matteob29/EA113_-_Generateur_de_son/Simulations/3)_Multiplieur/III.3.f).JPG

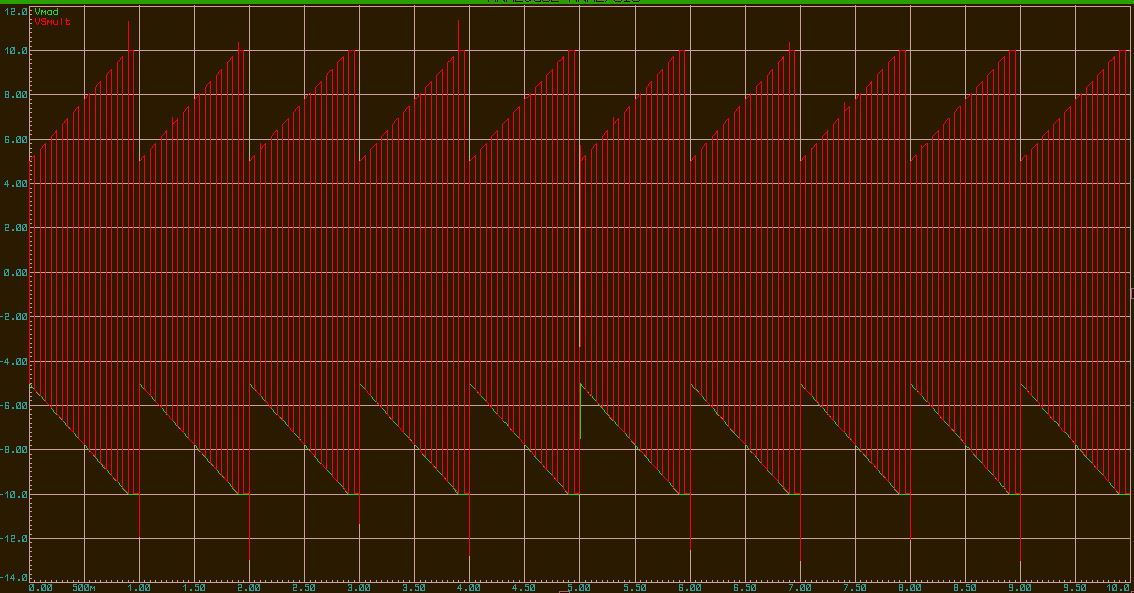
Simulations/3)_Multiplieur/III.3.f).JPG
