matteob29/EA113_-_Generateur_de_son/Simulations/5)_VCO_5/III.Vhf(t).JPG

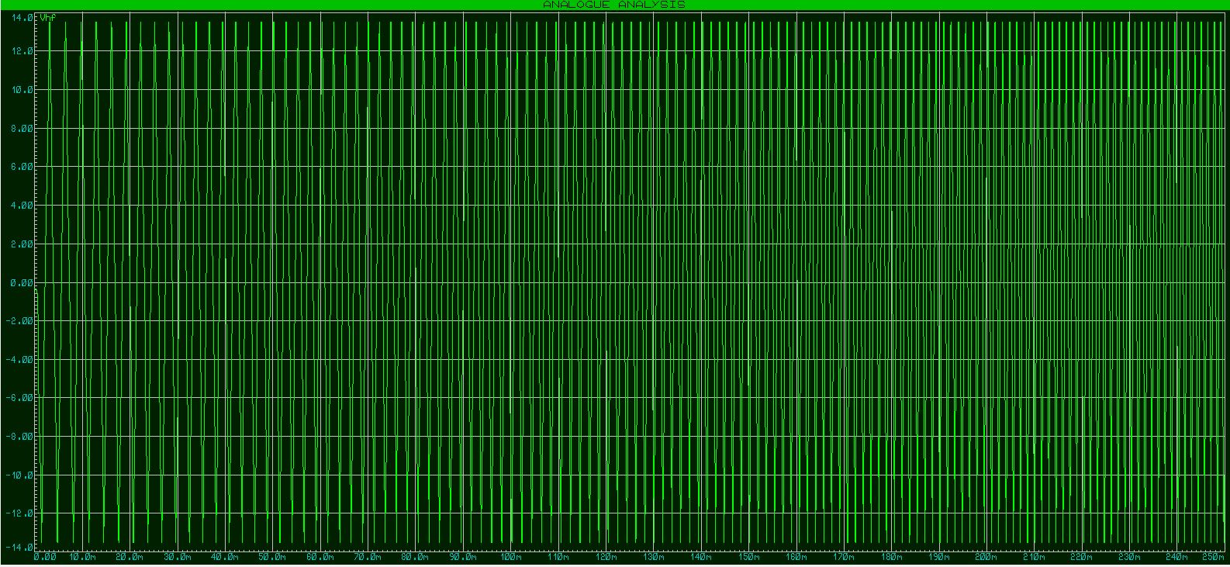
Simulations/5)_VCO_5/III.Vhf(t).JPG
