matteob29/EA113_-_Generateur_de_son/Rapport/[EA113] - générateur de son.pdf

# Générateur de son

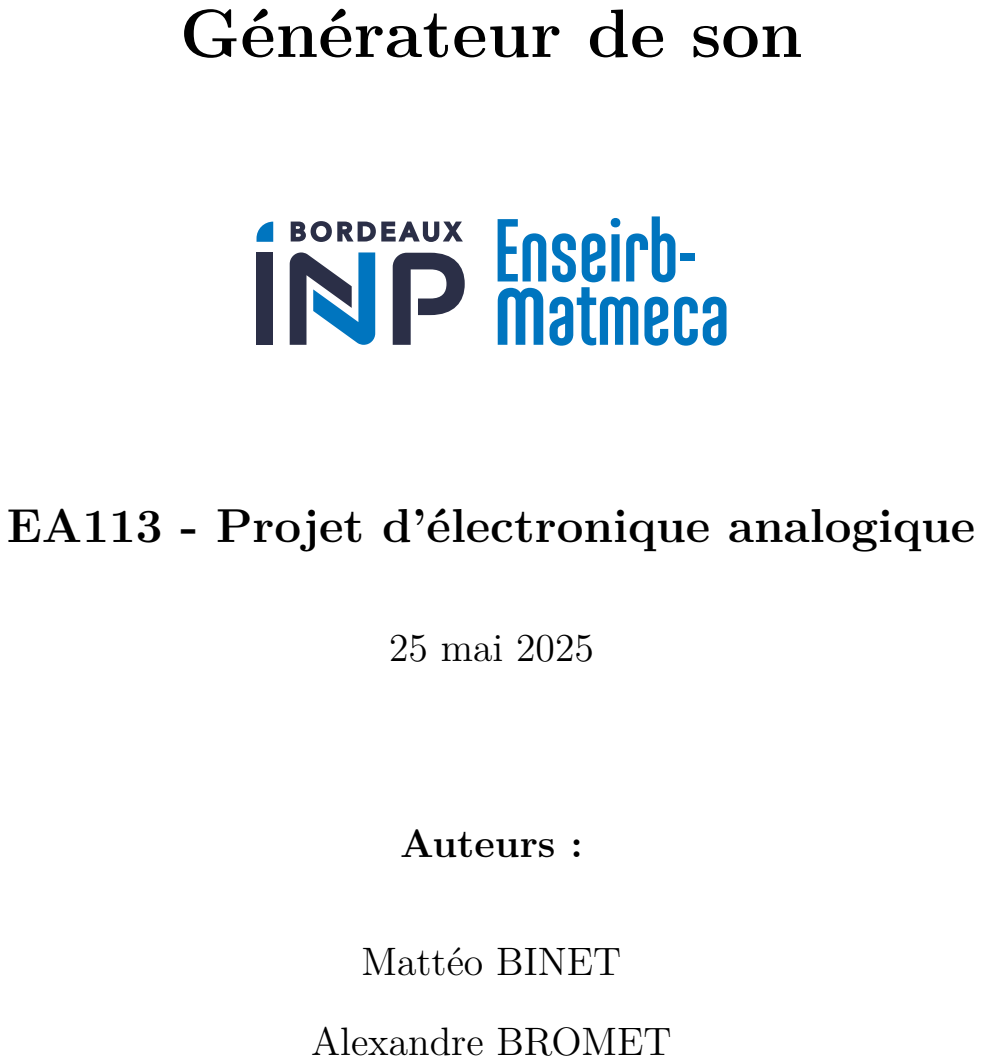
[picture p3: page 1]
25 mai 2025; Auteurs :; Mattéo BINET; Alexandre BROMET

EA113 - Projet d’électronique analogique

## Sommaire

Introduction | 1
1 Cahier des Charges | 1
2 Générateur de modulation NE555 | 2
3 Adaptation du signal généré par le NE555 | 2
4 Voltage Controlled Oscillator (VCO) | 3
5 Adaptation du signal sortant du VCO | 8
Conclusion | 9
Annexe | 10

EA113 - Projet d’électronique analogique

## Introduction

Ce rapport présente l’étude théorique du générateur de son conçu dans le cadre du projet EA113. L’objectif est de produire un signal audio modulé en fréquence à l’aide d’un oscillateur commandé en tension, selon un cahier des charges précis. L’analyse porte sur la conception des différents blocs fonctionnels, le choix et le dimensionnement des composants, ainsi que la validation par simulation et mesures.

## 1 Cahier des Charges

Le système à concevoir doit permettre la génération d’un signal sonore destiné à être diffusé sur un haut-parleur via un amplificateur audio. Le signal de sortie sera de forme triangulaire, avec une fréquence variant périodiquement entre deux valeurs extrêmes notées FMIN et FMAX, selon une modulation en fréquence (FM) de type wobulation.
Les principales exigences du cahier des charges sont les suivantes :

— Forme du signal : triangulaire, périodique et symétrique.
— Fréquences extrêmes : FMIN = 100 Hz, FMAX = 1500 Hz (valeurs à adapter selon l’effet sonore choisi).

— Type de modulation : variation pseudo-linéaire ou binaire, avec un signal modulant Vmod de fréquence faible (de l’ordre du hertz).

— Rapport cyclique de la modulation : adapté selon l’effet recherché (montée lente et descente rapide pour une sirène, par exemple).

— Amplitude du signal de sortie : ajustable, de 0 à environ 100 mV, compatible avec l’entrée de l’amplificateur.
— Alimentation : double alimentation symétrique ±15 V.

Le circuit doit être robuste, stable et répondre aux contraintes de dimensionnement en tenant compte des tolérances des composants. Sa conception doit également permettre une intégration simple sur une carte imprimée (PCB).

Mattéo BINET | 1 | Alexandre BROMET

## 2 Générateur de modulation NE555

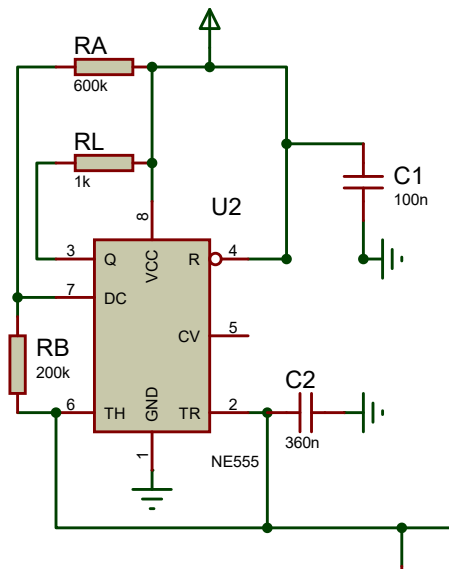
[picture p4: figure]
3 GND 1 VCC

Figure 1 – Schématique Proteus du générateur de modulation NE555

— C2 = 360 nF
— RA = 600 kΩ
— RB = 200 kΩ

La tension du signal de sortie est un signal triangle, variant entre 5 V et 10 V avec un temps de montée de 80% d’une période. De plus la fréquence de ce signal est de 4 kHz.

## 3 Adaptation du signal généré par le NE555

L’adaptation du signal généré par le NE555 est importante, car elle permet de s’affranchir des limitations de ce composant. Le niveau de tension du signal doit être abaissé, et le signal rendu négatif afin de favoriser le bon fonctionnement des étages suivants.

Pour obtenir une fréquence minimale de fmin = 350 kHz et une fréquence maximale de fmax = 850 kHz, il faut que la tension de modulation varie entre :

Vmodmin = −3.5 V et Vmodmax = −8.5 V

On souhaite alors réaliser une transformation affine de la forme :

Vmod = a · Vmod1 + b

avec les coefficients suivants :

a = −1 et b = 2 V

Étant donné que a < 0, un amplificateur opérationnel inverseur est utilisé. Après calculs, les valeurs des composants nécessaires sont :

Mattéo BINET | 2 | Alexandre BROMET

— R1 = R2 = 10 kΩ

— Eth =

b
1 − a

= 1 V

Enfin, un AOP monté en suiveur de tension est placé en amont du premier AOP afin d’adapter l’impédance entre l’étage de sortie du NE555 et l’étage d’adaptation.

TR | 2
CV | 5

NE555

C2

360n

1

J3
CONN1

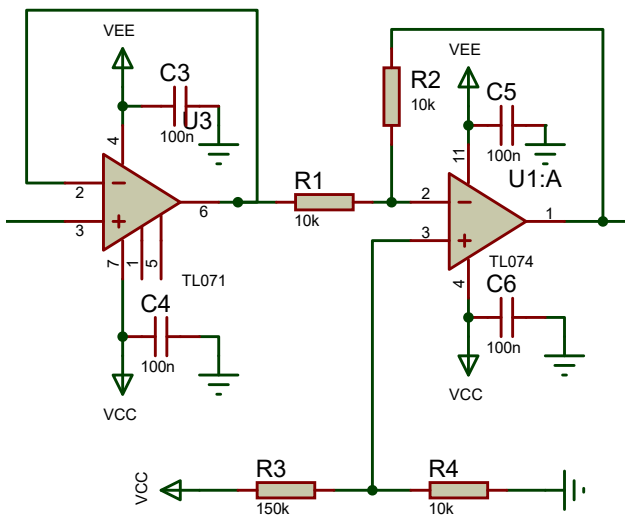
[picture p5: figure]
VCC; VEE; VCCR3

Figure 2 – Schématique Proteus de l’adaptation du signal de sortie du NE555

## 4 Voltage Controlled Oscillator (VCO)

Le VCO constitue le cœur du générateur de son, car il permet de convertir une tension de commande Vmod en une fréquence de sortie F. Il s’agit d’un oscillateur triangulaire dont la fréquence varie proportionnellement à l’amplitude de la tension appliquée. Cette variation permet de moduler le signal audio de façon contrôlée, en respectant les caractéristiques du son à produire (sirène, alarme, etc.).
Le montage repose sur une architecture classique composée d’un comparateur à hystérésis et d’un intégrateur. Le comparateur fixe les seuils de commutation, tandis que l’intégrateur génère la forme triangulaire. Pour rendre le système sensible à Vmod, une fonction de multiplication est insérée entre les deux blocs, ce qui permet d’ajuster dynamiquement le courant d’intégration, et donc la fréquence.
Pour ce faire, le VCO est composé de trois parties : le comparateur à hystérésis, le multiplieur et l’intégrateur, avec une rétroaction entre la sortie de l’intégrateur et l’entrée du comparateur.
Mattéo BINET | 3 | Alexandre BROMET

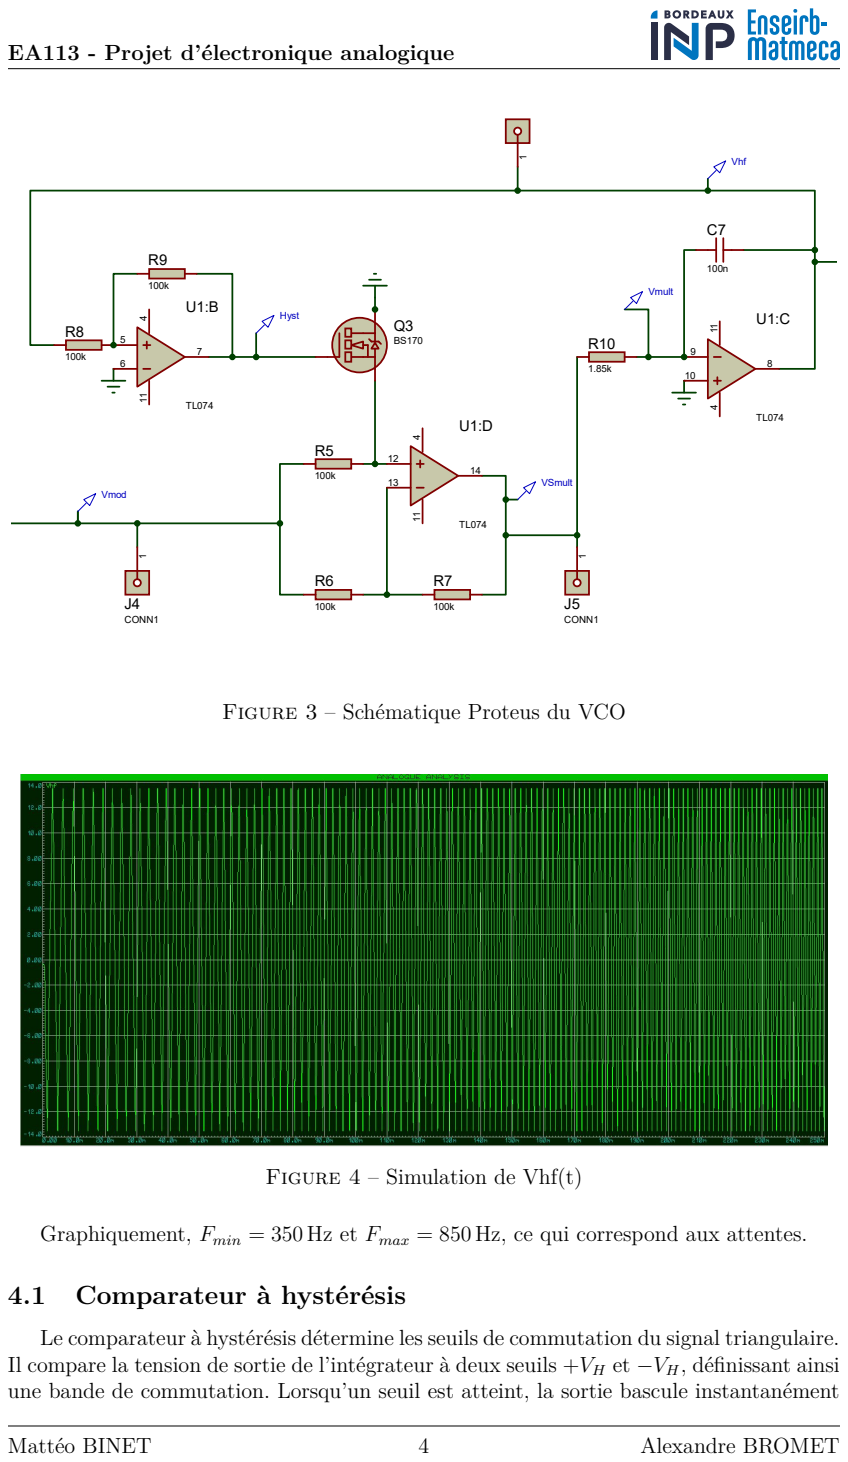
[picture p6: page 8]

Figure 3 – Schématique Proteus du VCO

Figure 4 – Simulation de Vhf(t)

Graphiquement, Fmin = 350 Hz et Fmax = 850 Hz, ce qui correspond aux attentes.

Le comparateur à hystérésis détermine les seuils de commutation du signal triangulaire.
Il compare la tension de sortie de l’intégrateur à deux seuils +VH et −VH, définissant ainsi
une bande de commutation. Lorsqu’un seuil est atteint, la sortie bascule instantanément

entre +Vsat et −Vsat, générant une commande pour inverser la pente du signal triangulaire via le multiplieur.
La tension d’entrée devra donc franchir +VH ou −VH pour provoquer une commutation. Ces seuils déterminent ainsi l’amplitude crête du signal triangulaire et participent directement à la définition de sa période.
La fréquence d’oscillation du VCO peut être exprimée, en fonction de la tension de modulation Vmod, des composants R et C, et du seuil VH, par la relation :

f =

Vmod
4R10C7VH

(1)

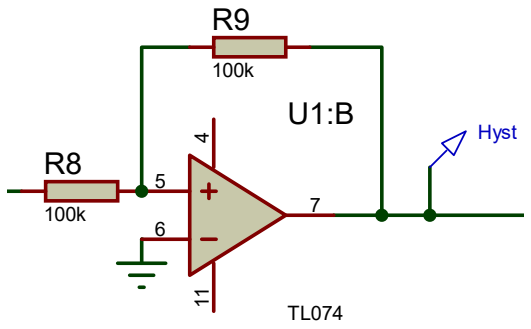
[picture p7: figure]
Hyst

Figure 5 – Schématique Proteus du comparateur à hystérésis

Le seuil VH est défini par le pont diviseur de la contre-réaction positive :

VH =

R8
R9
- Vsat | (2)

Dans notre dimensionnement, nous avons choisi R8 = R9 = 100 kΩ, donc VH = Vsat pour simplifier les valeurs des composants. Ce choix permet donc de laisser le réglage de f à R10 et C7.

### 4.2 Multiplieur

Le multiplieur a pour rôle de convertir la sortie ±Vsat du comparateur à hystérésis en une tension ±Vmod proportionnelle à la tension de modulation. Cette opération permet de rendre la pente du signal triangulaire, et donc la fréquence d’oscillation, dépendante de Vmod.
Le circuit utilisé repose sur un amplificateur opérationnel associé à quatre résistances, dont l’une est substituée par un interrupteur commandé (transistor BS170). L’expression du gain est donnée par :
Mattéo BINET | 5 | Alexandre BROMET

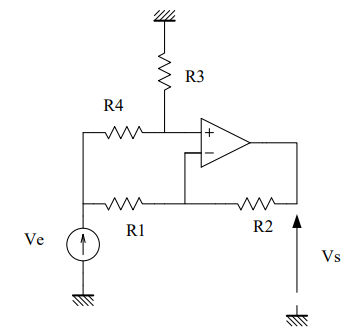
[picture p8: figure]

Figure 6 – Schéma du multiplieur

A =

Vs
Ve

=

R3(R2 + R1) − R2(R3 + R4)
R1(R3 + R4)

(3)

Avec R1 = R2 = R4 = R, alors on a :

A =

RR3 − R²
RR3 + R²

(4)

Lorsque R3 = 0 V, A = -1 et lorsque R3 −→ ∞, A −→ 1.
Pour avoir un multiplieur ±1, il faut que R3 soit un interrupteur. Un NMOS est utilisé pour l’interrupteur.
Mattéo BINET | 6 | Alexandre BROMET

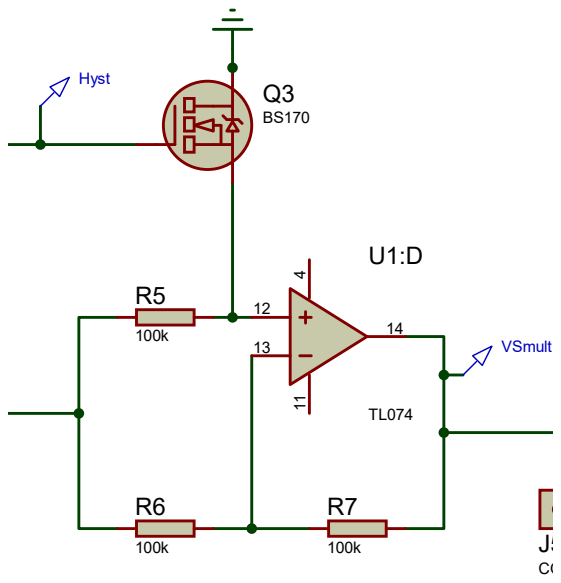
[picture p9: figure]
VSmult; Hyst; CONN1

5

6

Vmod

J4

Figure 7 – Schématique Proteus du multiplieur

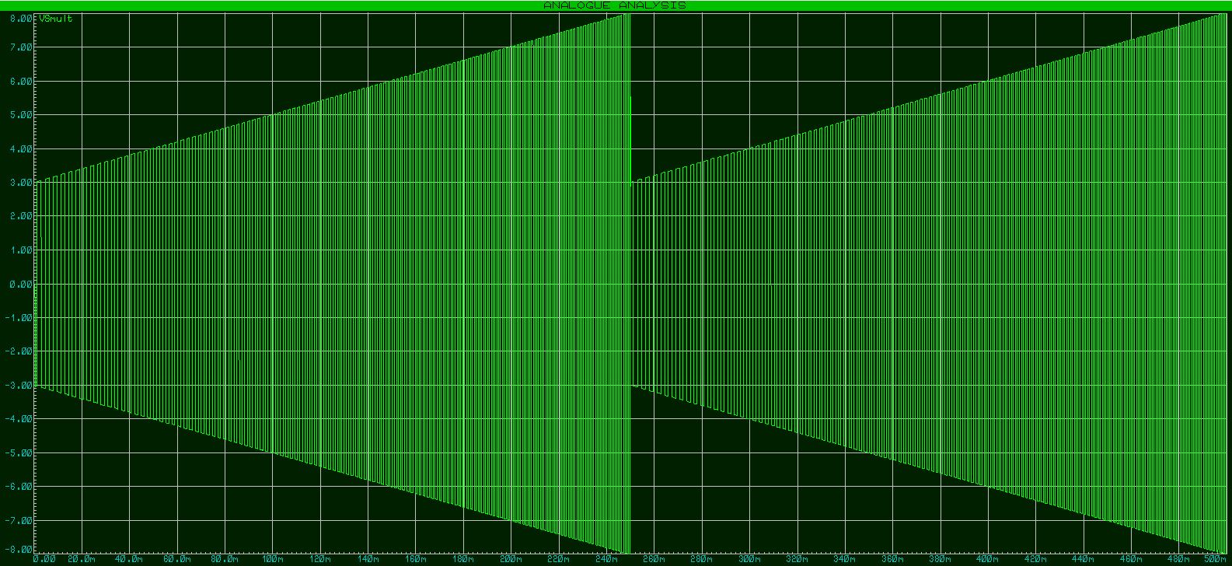
[picture p10: figure]

Figure 8 – Simulation de VSmult(t)

### 4.3 Intégrateur

L’intégrateur a pour rôle de transformer le signal issu du multiplieur, de la forme ±Vmod, en un signal triangulaire ±VHF, dont la fréquence dépend directement de Vmod. Dans notre cas, cette fréquence varie de 350 Hz à 850 Hz.
Le circuit de l’intégrateur est constitué d’une résistance en série avec l’entrée inverseuse d’un amplificateur opérationnel, et d’un condensateur connecté en parallèle entre la sortie et l’entrée inverseuse, réalisant ainsi une intégration temporelle du signal d’entrée.
Mattéo BINET | 7 | Alexandre BROMET

U1:D

1

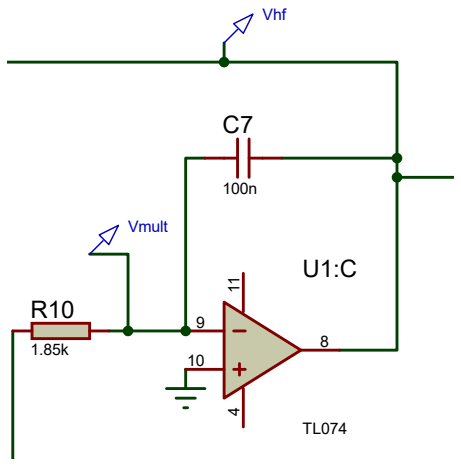
[picture p11: figure]
Vmult; Vhf

Figure 9 – Schématique Proteus de l’intégrateur

La fréquence du signal triangulaire obtenu en sortie s’exprime selon la relation suivante :
f =

1

4R10C7

R8
R8 + R9
Vsat
- |Vmod|

où :

— R10 est la résistance d’entrée de l’intégrateur,

— C7 est le condensateur d’intégration,

— Vsat est la tension de saturation du comparateur,
— R8 et R9 sont les résistances du comparateur à hystérésis (voir section 4.1).

Afin que la fréquence varie entre 350 Hz et 850 Hz pour une amplitude de modulation |Vmod| comprise entre 3.5 V et 8.5 V, nous avons choisi les valeurs suivantes :

C7 = 100 nF et R10 = 1.85 kΩ

## 5 Adaptation du signal sortant du VCO

Le signal de sortie du VCO varie entre ±VHF. Sachant que VHF est de quelques volts et que le générateur de son est branché à un amplificateur audio, sans adaptation du signal de sortie du VCO, le son généré serait beaucoup trop fort.
Cette adaptation permet de fixer une tension maximale de sortie à une centaine de millivolts. Elle permet également de régler manuellement la tension de sortie grâce au potentiomètre présent sur le circuit.

Le circuit d’adaptation est un diviseur de tension constitué d’une résistance fixe R11 et d’un potentiomètre RV 1 = 2kΩ, placé en parallèle avec l’entrée de l’amplificateur, dont l’impédance est Rin = 47 kΩ.

Mattéo BINET | 8 | Alexandre BROMET

R11
150k 92%

1 2

3

RV1

1K

Figure 10 – Schématique Proteus de l’adaptation du signal de sortie du VCO

L’expression du rapport de division s’écrit :

Vout

VCC

=

RV 1 · Rin

RV 1 + Rin

·

1
RV 1·Rin
RV 1+Rin
+ R11 | (5)

On choisit alors R11 = 47 kΩ (erreur dans le schématique) afin que le signal de sortie varie entre 0 mV et 150 mV.

## Conclusion

Ce projet EA113 nous a permis de concevoir, simuler, réaliser et tester un générateur de son répondant à un cahier des charges précis. Grâce aux simulations sous PROTEUS, nous avons validé nos choix techniques avant la fabrication du circuit imprimé.
La réalisation pratique du PCB, suivie des tests et mesures, a confirmé le bon fonctionnement de l’amplificateur, malgré quelques ajustements nécessaires en cours de montage. Ce projet nous a permis de mieux comprendre les enjeux de la conception analogique, de la théorie à l’application concrète.
Mattéo BINET | 9 | Alexandre BROMET

## Annexe

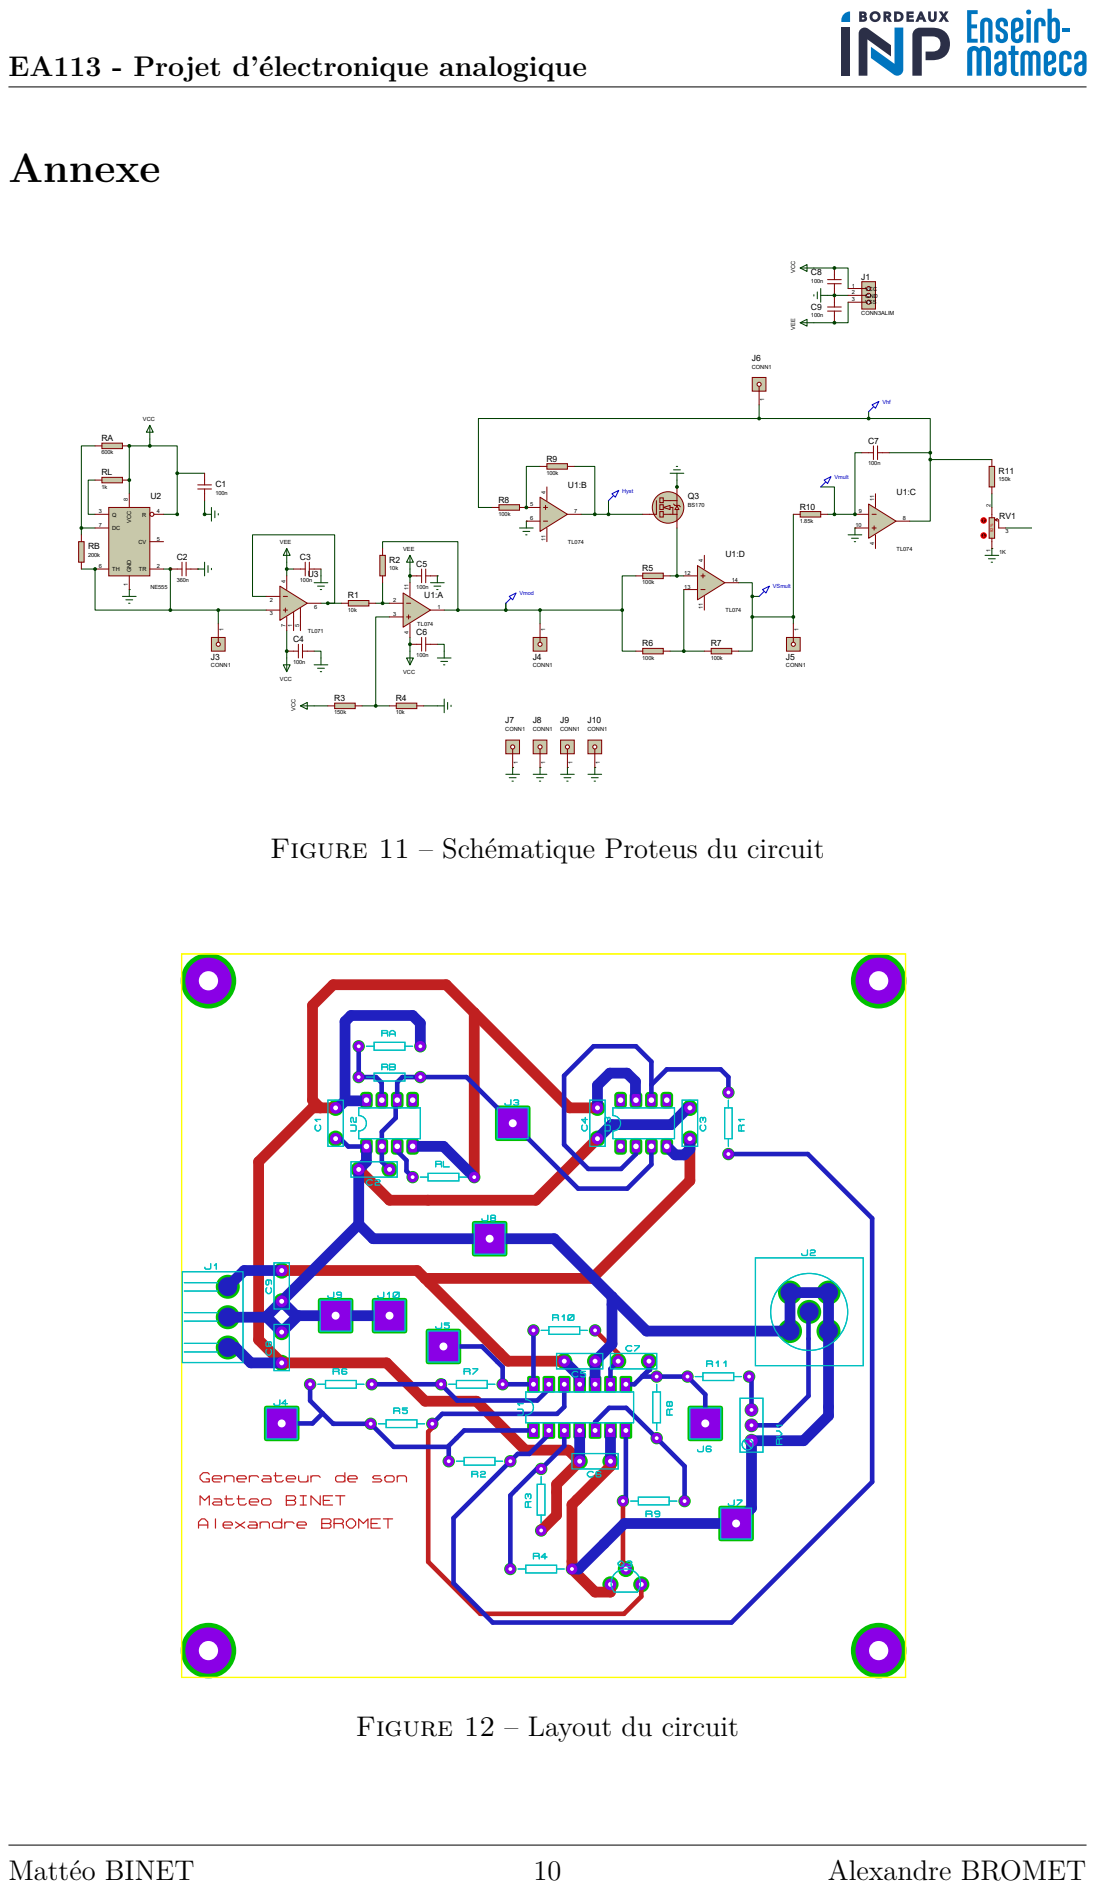
[picture p12: page 14]

Figure 11 – Schématique Proteus du circuit

Figure 12 – Layout du circuit

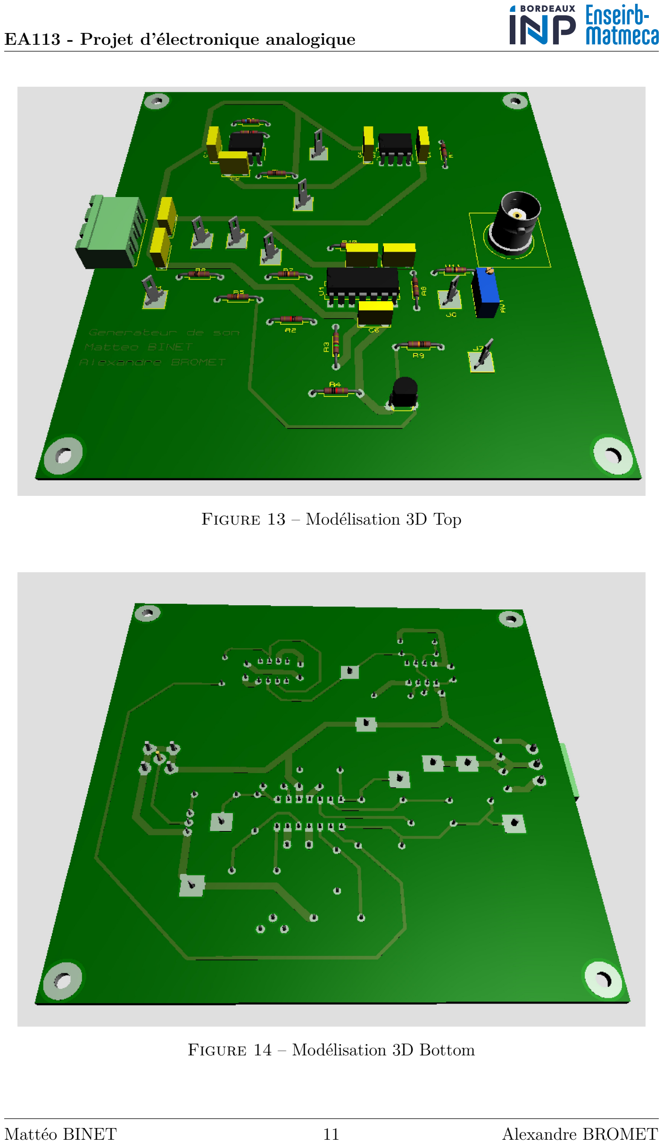
[picture p13: page 15]

Figure 13 – Modélisation 3D Top

Figure 14 – Modélisation 3D Bottom

Mattéo BINET | 11 | Alexandre BROMET

Bill Of Materials for VCO

Design Title | VCO
Author
Document Number
Revision
Design Created | vendredi 4 avril 2025
Design Last Modified vendredi 25 avril 2025 Total Parts In Design 38

38 =PACKAGE
Quantity | References | PCB package | Value
8 | C1,C3,C4,C5,C6,C7,C8,C9 | CAP20B_E | 100n
1 | C2 | CAP20B_E | 360n
1 | J1 | BORNIER3_H_E | CONN3ALIM
1 | J2 | BNC_B | BNC
8 | J3,J4,J5,J6,J7,J8,J9,J10 | CN1_A | CONN1
1 | Q3 | TO92_E | BS170
3 | R1,R2,R4 | RES40 | 10k
2 | R3,R11 | RES40 | 150k
5 | R5,R6,R7,R8,R9 | RES40 | 100k
1 | R10 | RES40 | 1.85k
1 | RA | RES40 | 600k
1 | RB | RES40 | 200k
1 | RL | RES40 | 1k
1 | RV1 | TRIM_B | 1K
1 | U1 | DIP14_3E | TL074
1 | U2 | DIP8_3E | NE555
1 | U3 | DIP8_3E | TL071
Sub-totals:

Totals:

| | | vendredi 25 avril 2025 12:28:04

Figure 15 – Bill of Materials

Mattéo BINET | 12 | Alexandre BROMET
