matteob29/EA113_-_Generateur_de_son/PCB/modélisation_3D_Bottom.pdf

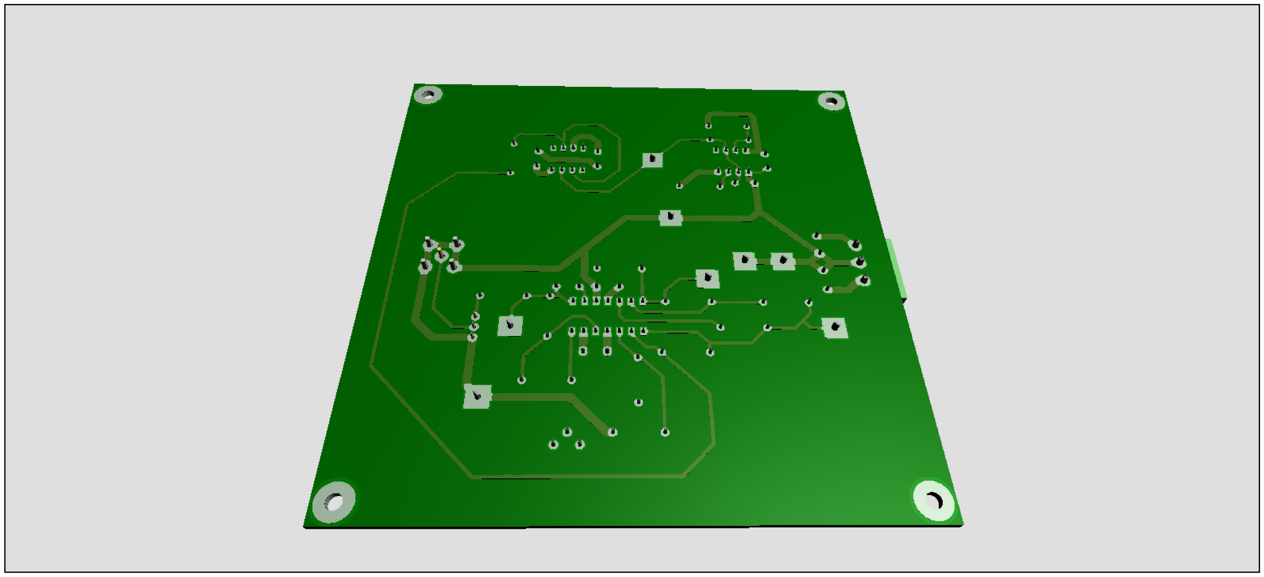
[picture p14: figure]
