matteob29/EA113_-_Generateur_de_son/PCB/modélisation_3D_Top.pdf

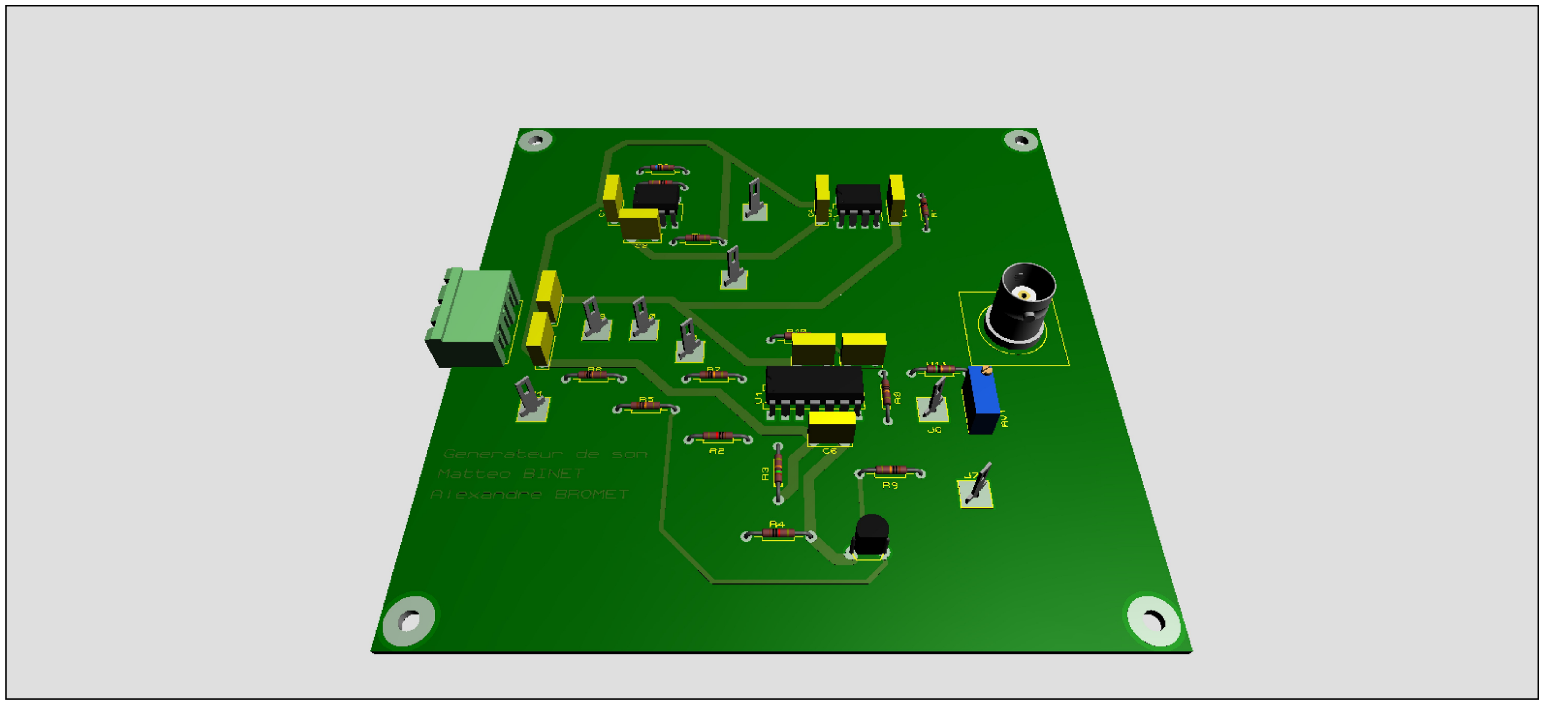
[picture p15: figure]
