matteob29/EA113_-_Generateur_de_son/Simulations/1)_Générateur_du_signal_de_balayage/III.1.c).JPG

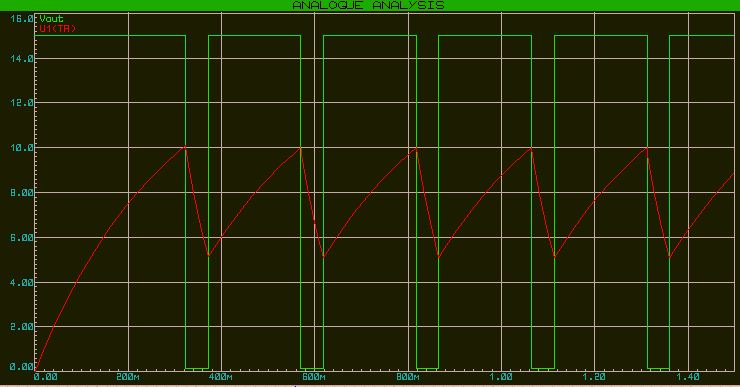
Simulations/1)_Générateur_du_signal_de_balayage/III.1.c).JPG
