matteob29/EA113_-_Generateur_de_son/Simulations/4)_Adaptation_de_tension_du_signal_de_modulation/III.Vmod(t)_Vmod1(t).JPG

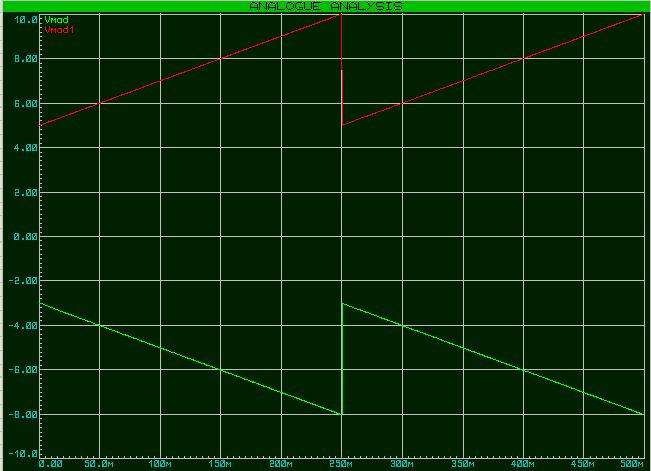
Simulations/4)_Adaptation_de_tension_du_signal_de_modulation/III.Vmod(t)_Vmod1(t).JPG
