matteob29/EA113_-_Generateur_de_son/PCB/schematic.pdf

J1

C8

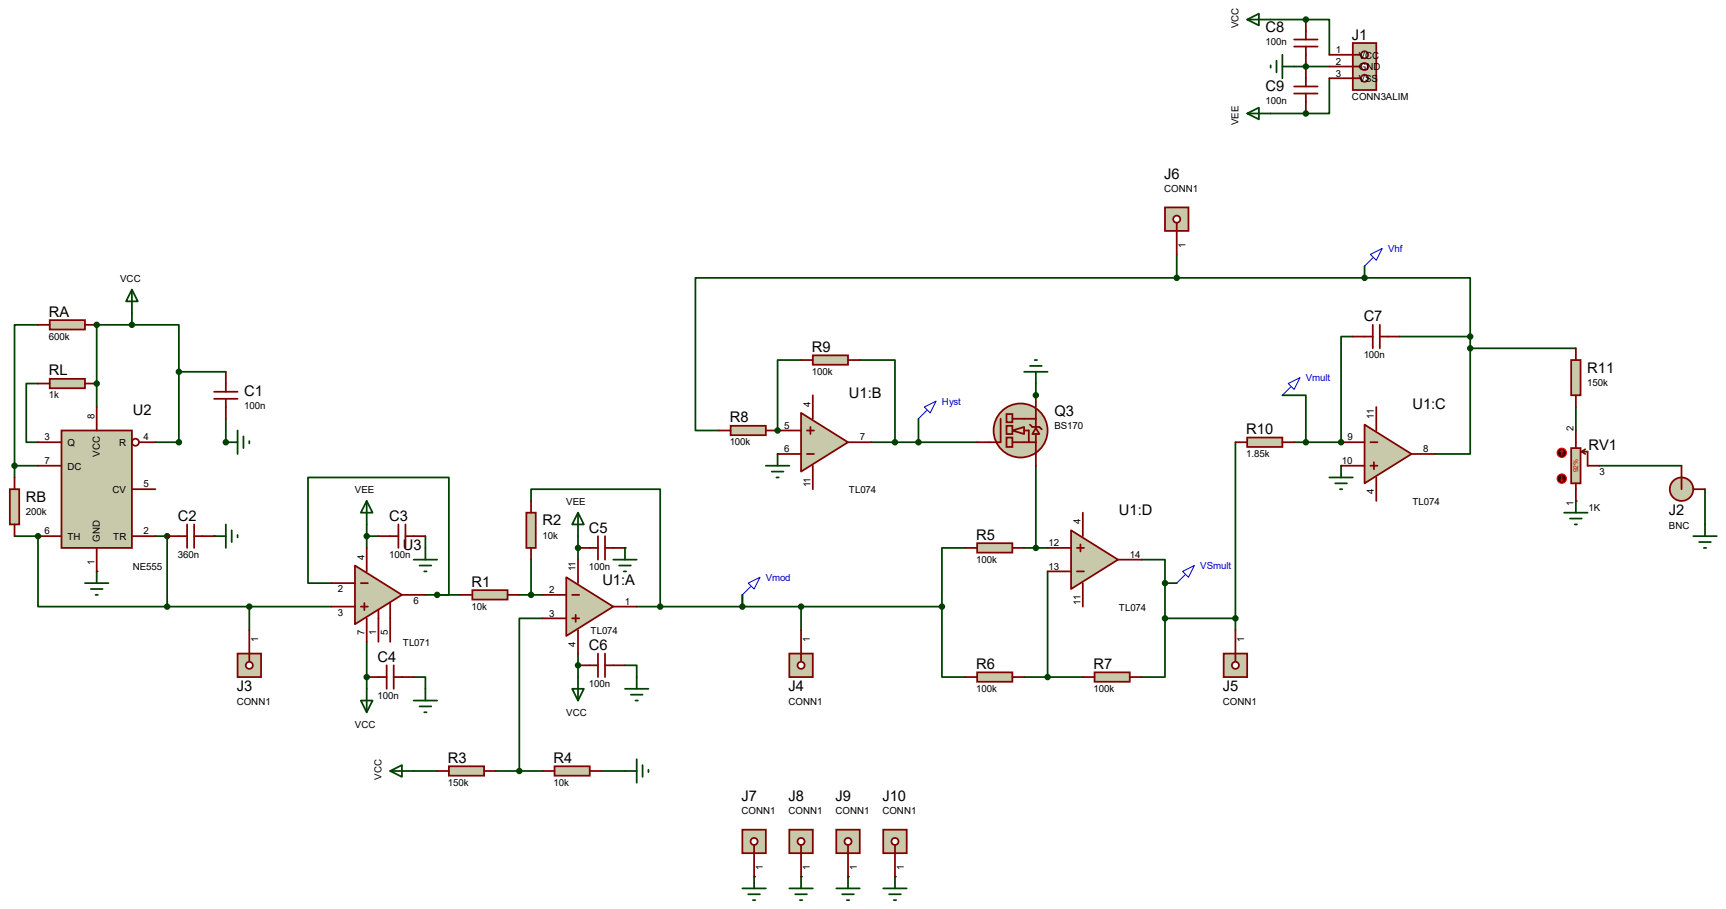
[picture p18: page 1]
