matteob29/EA113_-_Generateur_de_son/PCB/layout.pdf

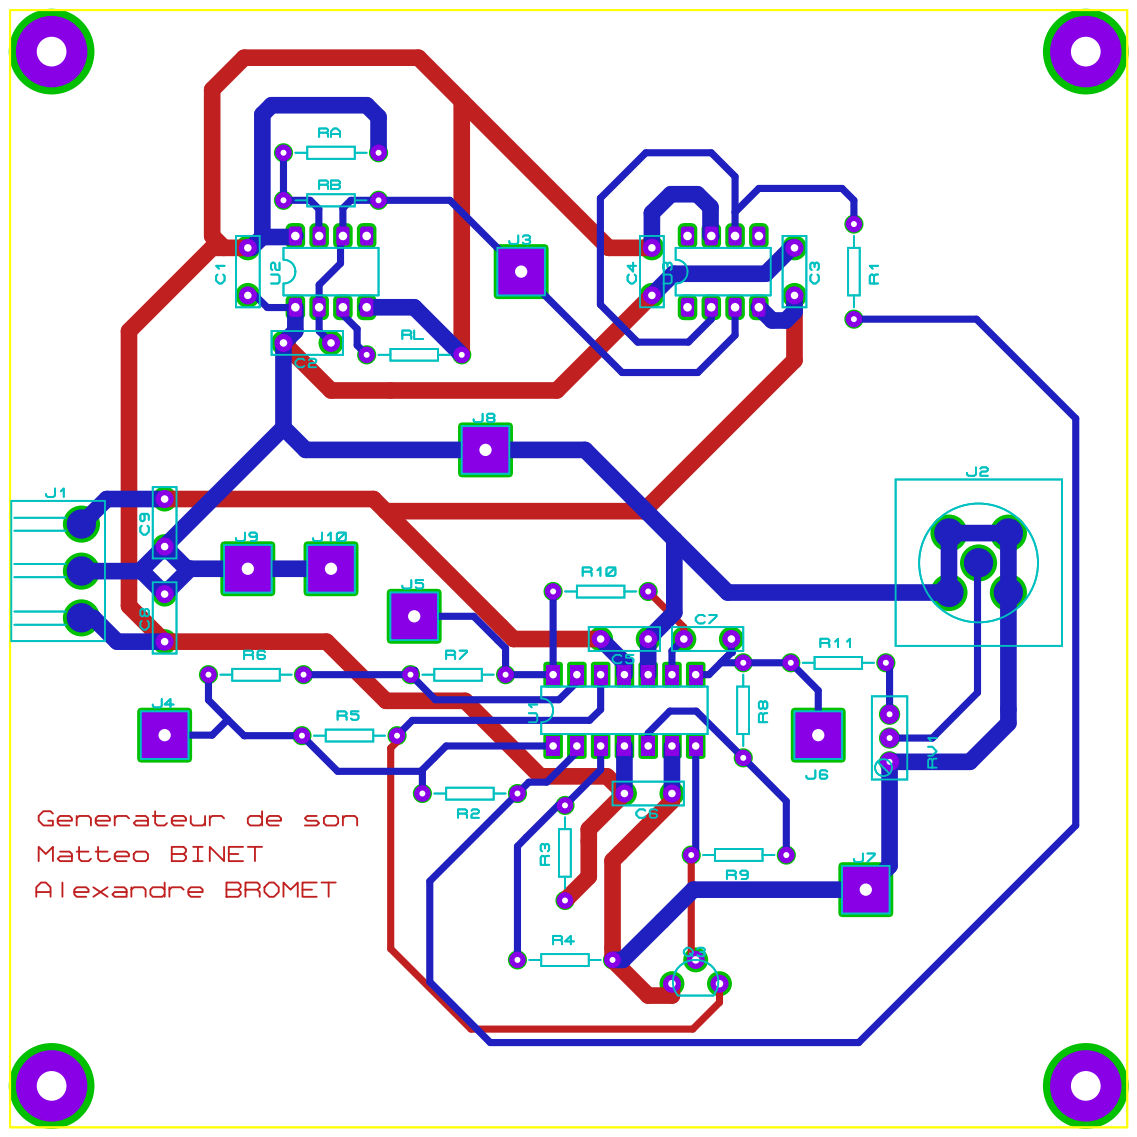
[picture p19: page 1]
