matteob29/EA113_-_Generateur_de_son/(list of files, drawings)

Other design files:
Proteus/VCO.pdsprj
